bastlirna/esp8266-board/pcb/IMG_2480.JPG

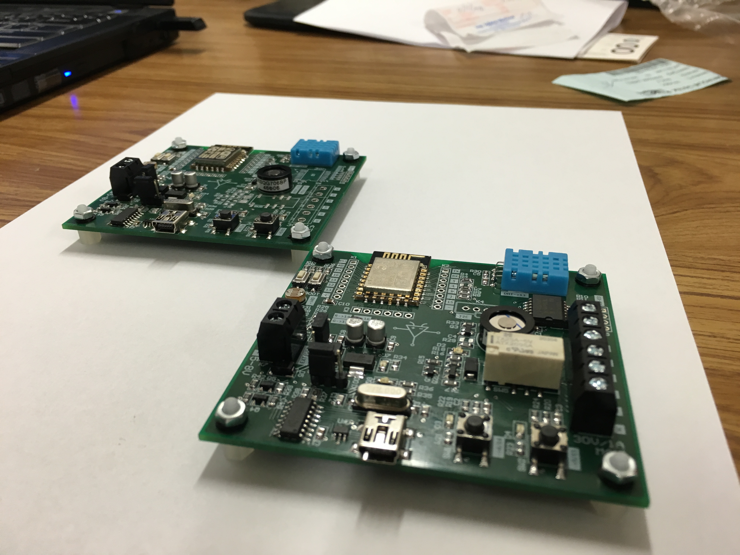
pcb/IMG_2480.JPG
