bastlirna/esp8266-board/pcb/IMG_2481.JPG

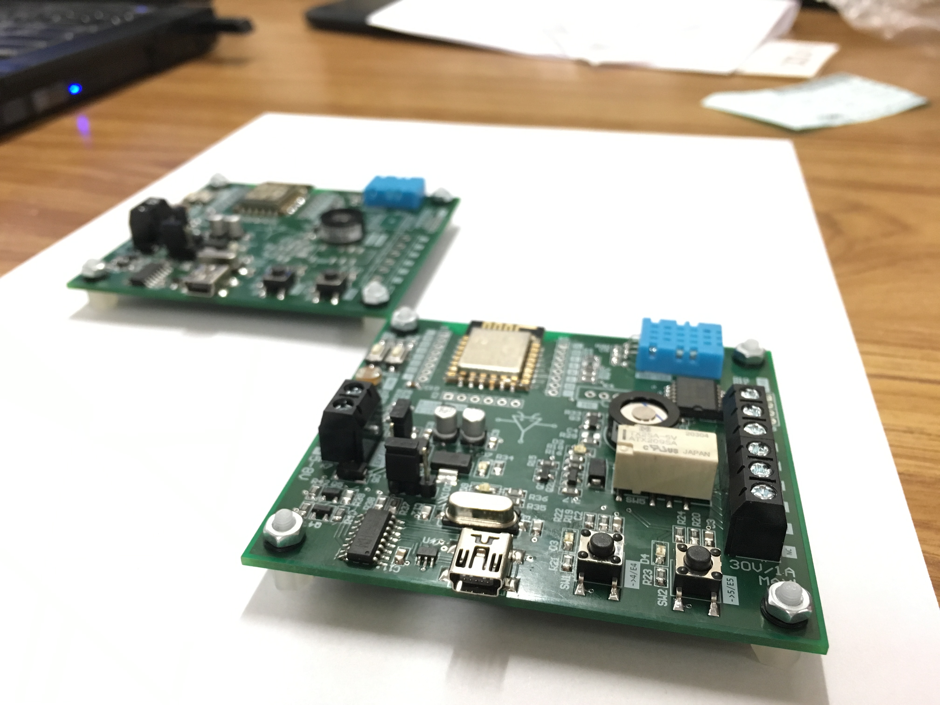
pcb/IMG_2481.JPG
