bastlirna/esp8266-board/doc/lua.md

# Lua on ESP board

## Links

- FW https://github.com/nodemcu/nodemcu-firmware
- https://github.com/espressif/esptool
- https://learn.adafruit.com/diy-esp8266-home-security-with-lua-and-mqtt/overview
- https://nodemcu-build.com/

- https://www.tutorialspoint.com/lua/lua_basic_syntax.htm
