bastlirna/esp8266-board/pcb/3D-v4.png

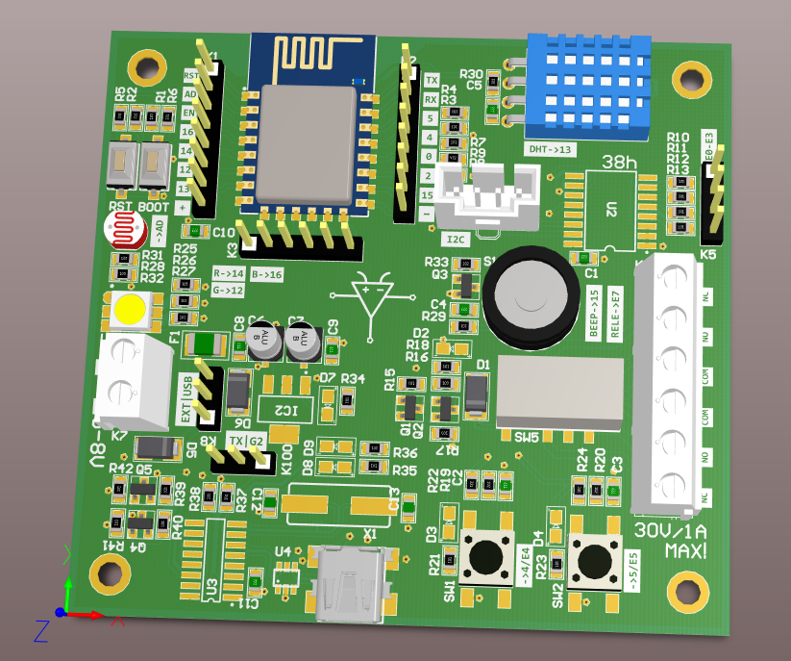
pcb/3D-v4.png
