bastlirna/esp8266-board/pcb/IMG_2476.JPG

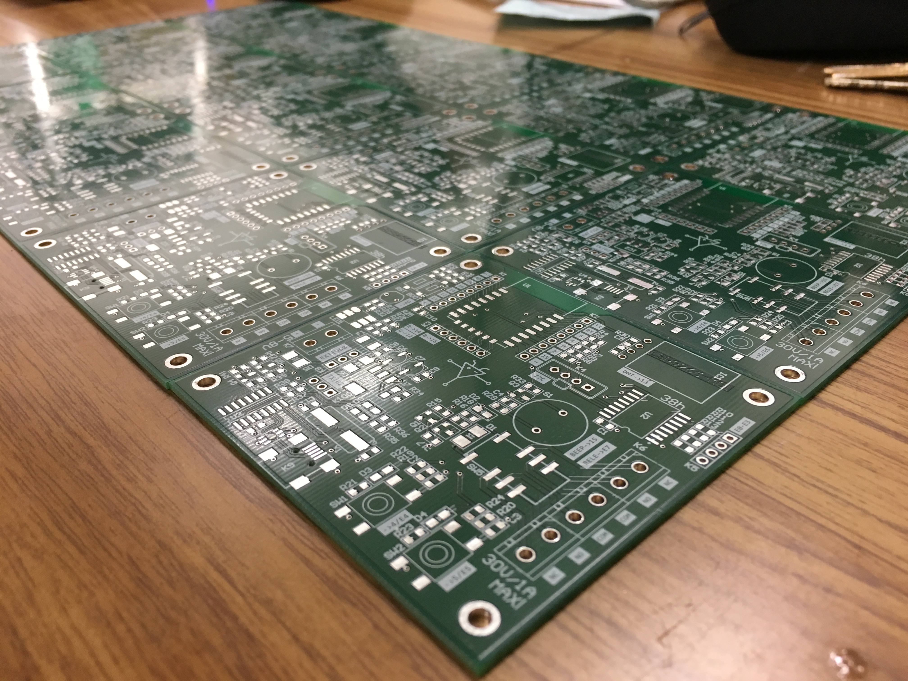
pcb/IMG_2476.JPG
