bastlirna/esp8266-board/pcb/IMG_2477.JPG

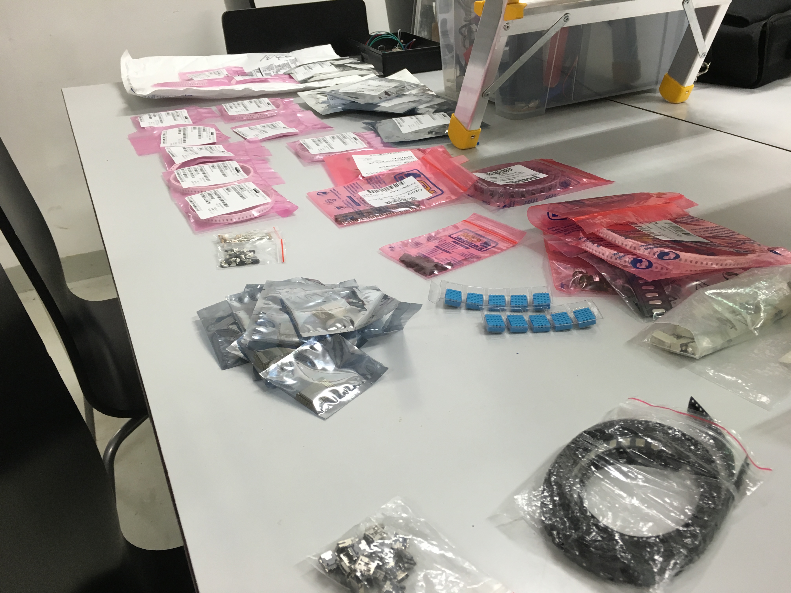
pcb/IMG_2477.JPG
