bastlirna/esp8266-board/pcb/IMG_2479.JPG

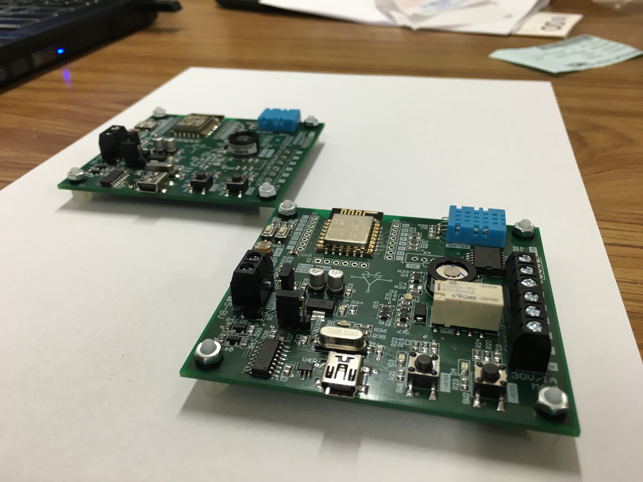
pcb/IMG_2479.JPG
