bastlirna/esp8266-board/pcb/IMG_2482.JPG

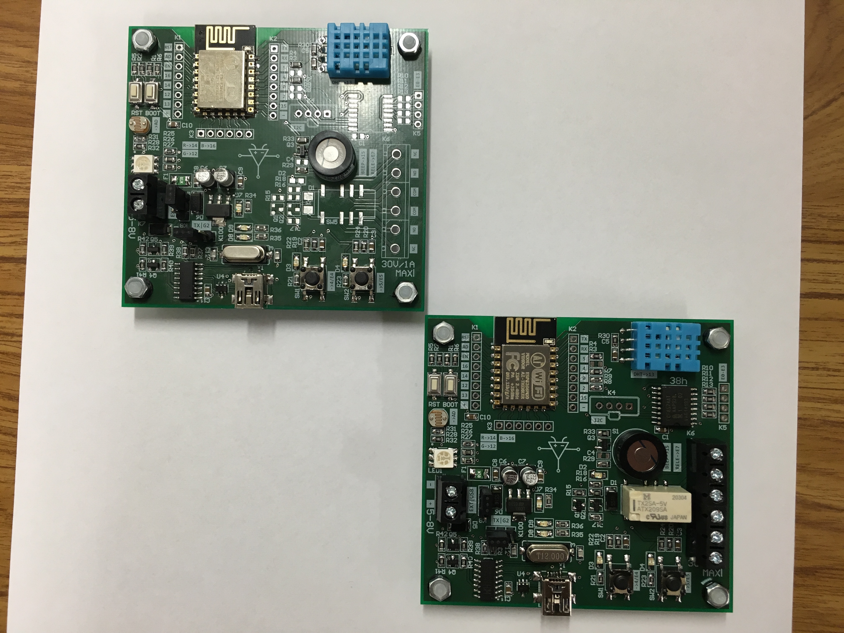
pcb/IMG_2482.JPG
