bastlirna/esp8266-board/test/arduino/board-test-bin/readme.txt

Eaxample command to download test to board:

esptool.exe -vv -cd nodemcu -cb 921600 -cp COM3 -ca 0x00000 -cf board-test.ino.bin
