bastlirna/esp8266-board/doc/bugs.md

### microPython ###
**Demo board v1.0 - 2016**

- pin(16) used only for wakeup from deepsleep mode
