bastlirna/esp8266-board/(threads)

Thread 1 (2016-10-22):

RGB LED bad adress

Kenny11CZ, 2016-10-22:
File:  esp8266-board/code/arduino/rgb/rgb.ino

```
#define LED_R 12
#define LED_G 14
```

 should be:

```
#define LED_R 14
#define LED_G 12
```

ah01, 2016-10-23:
Fixed. Thanks for notice.

Closed 2016-10-23.
