bastlirna/esp8266-board/(commit log)

2016-03-06 PCB doc
2016-03-28 Add table of all assembled boards
    [boards.xlsx]
2016-10-07 Add list of mac addresses of demo boards
    [boards.xlsx]
2016-10-07 Add missing boards (15, 9)
    [boards.xlsx]
2016-10-23 Swap Green and Red LED (fix #1)
    [rgb.ino]
2017-01-29 Lua samples
2017-07-31 Add link to workshop materials
