bastlirna/esp8266-board/pcb/IMG_2478.JPG

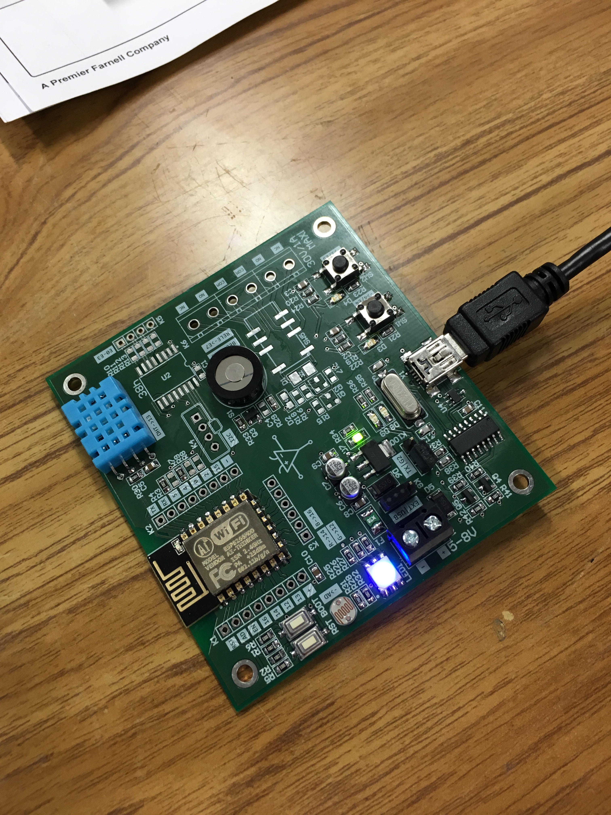
pcb/IMG_2478.JPG
